dlandry8/alarmClock/notes 2020 1 1.jpg

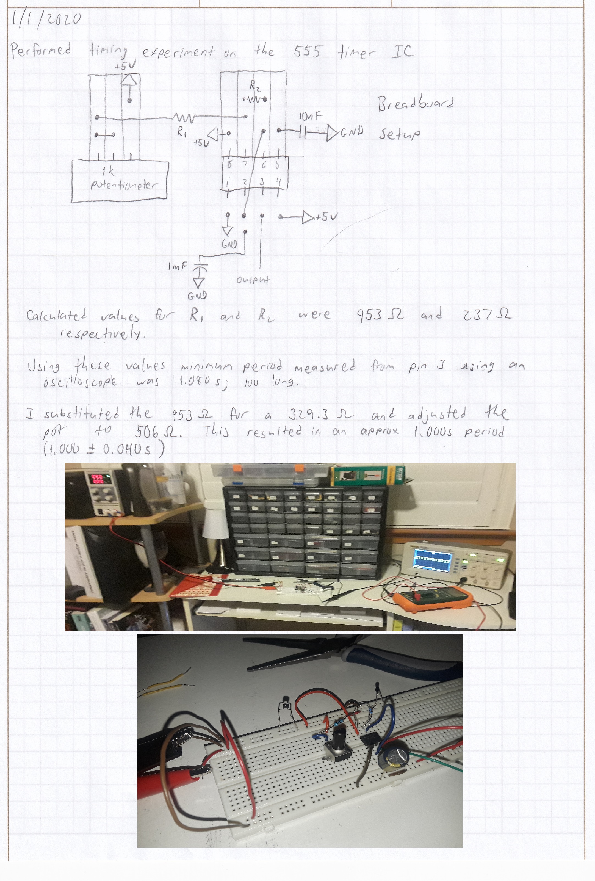
notes 2020 1 1.jpg
