dlandry8/alarmClock/box for clock.jpg

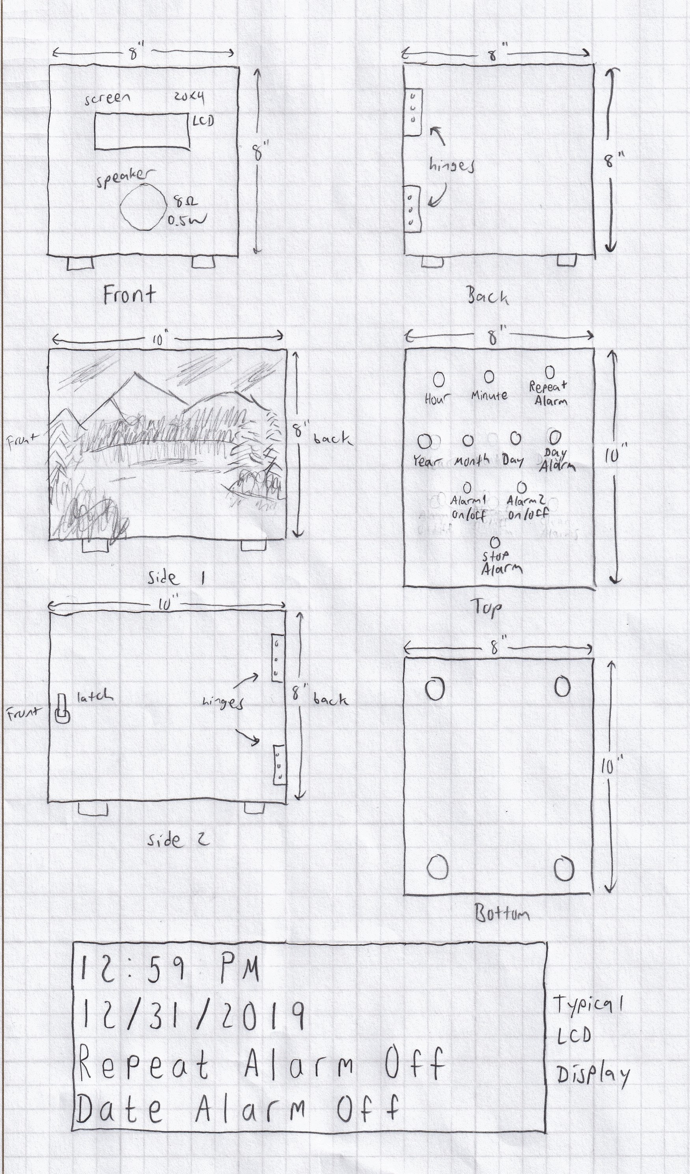
box for clock.jpg
