dlandry8/alarmClock/clock 0.8 Beeper.jpg

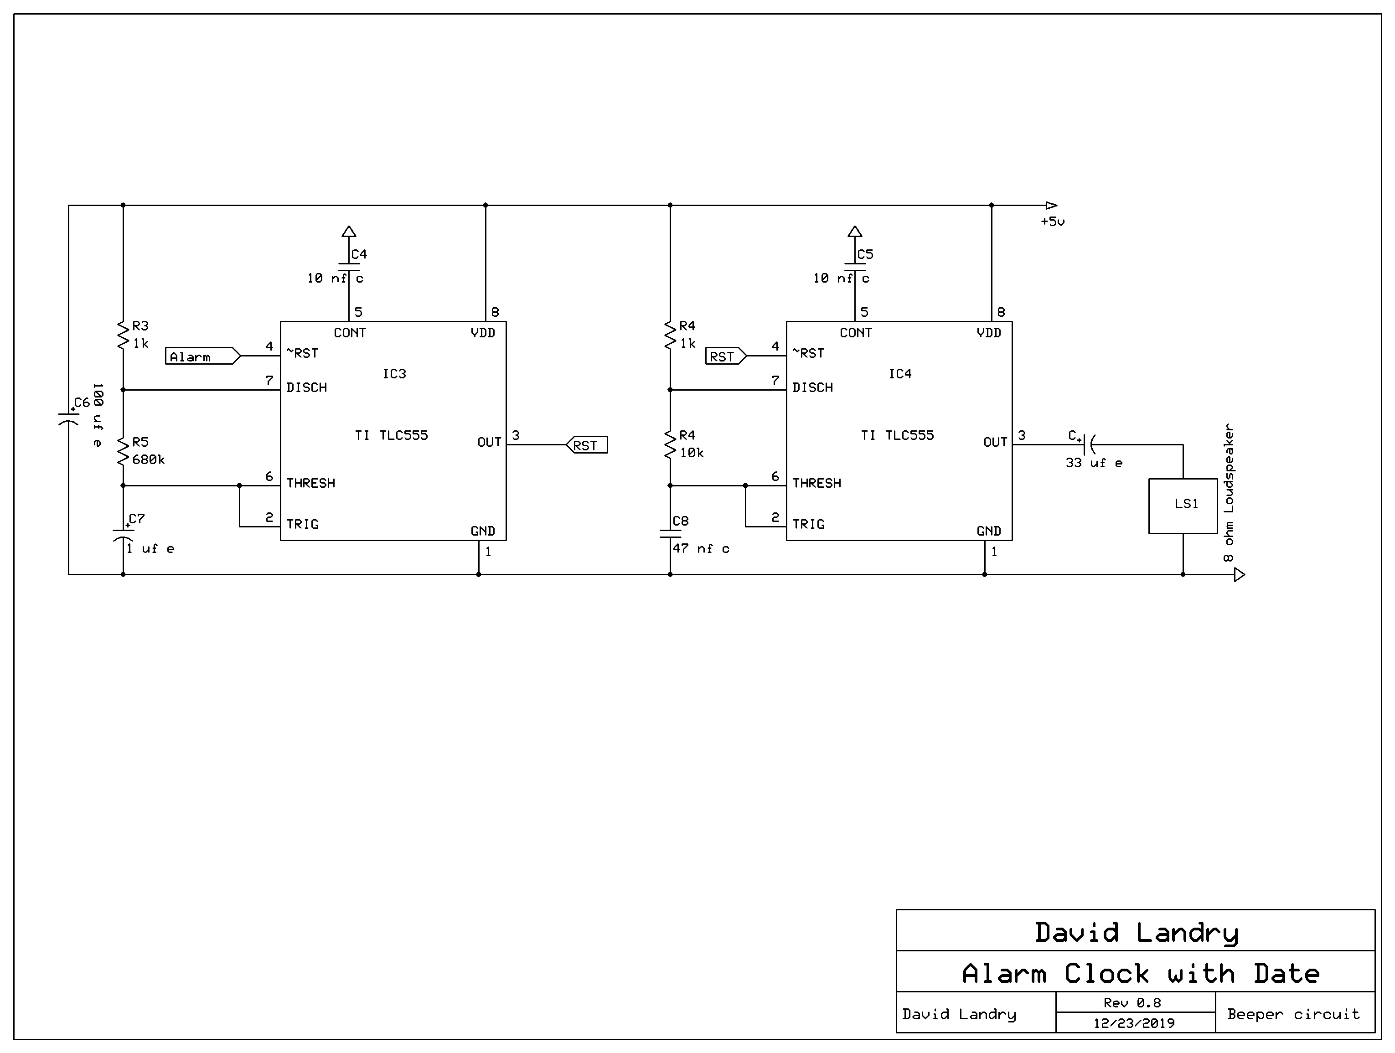
clock 0.8 Beeper.jpg
