dlandry8/alarmClock/clock 0.8 Buttons_Adapters.jpg

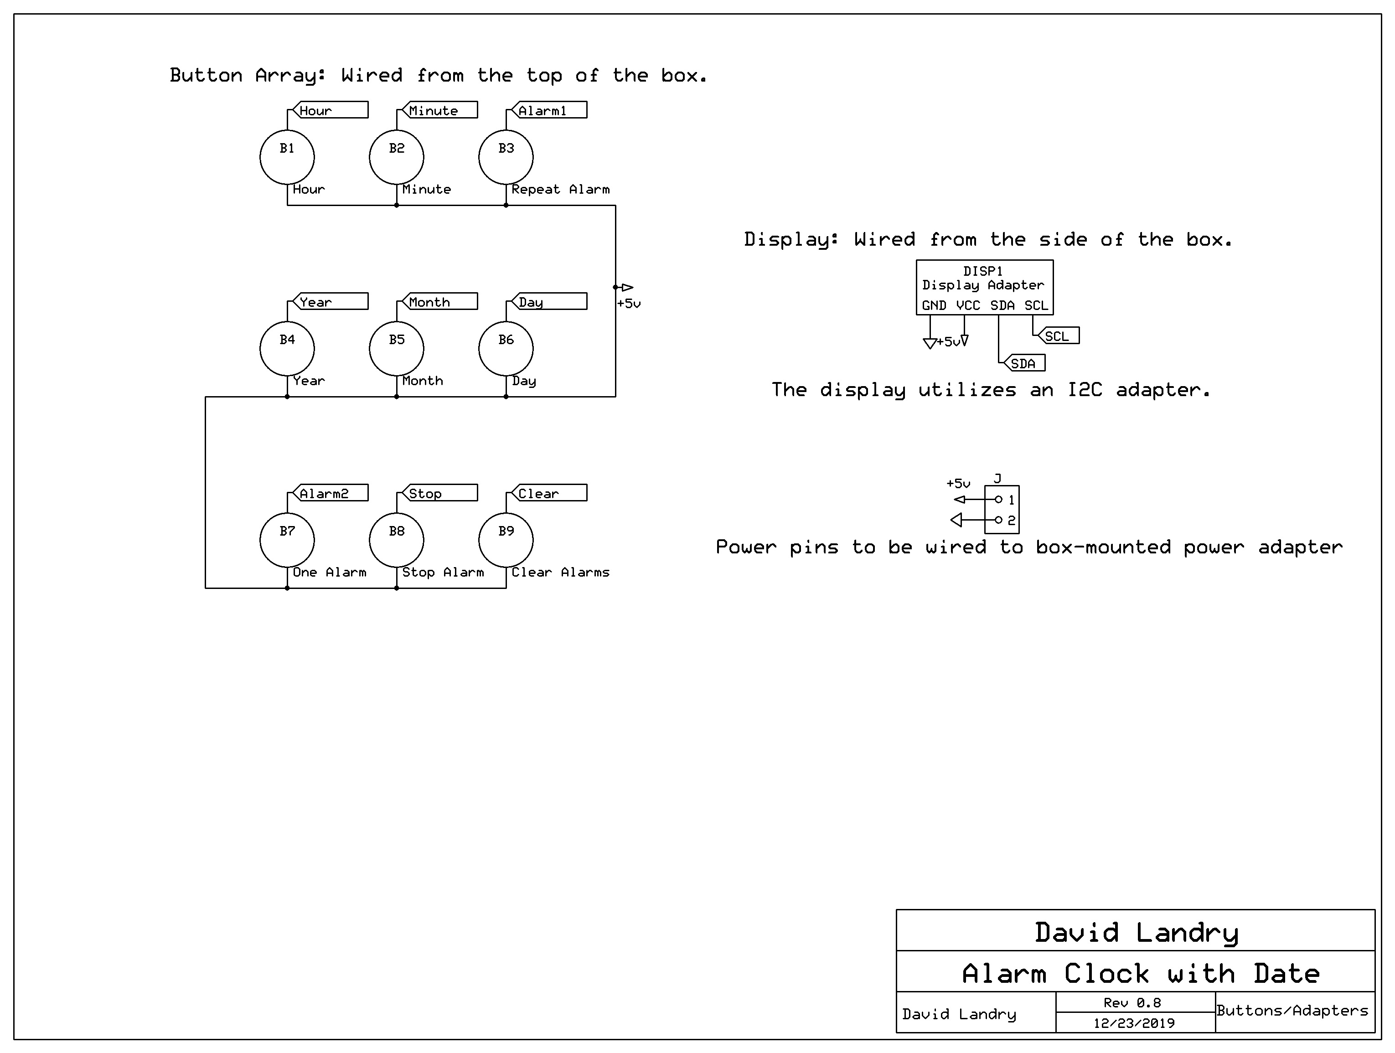
clock 0.8 Buttons_Adapters.jpg
