dlandry8/alarmClock/clock 0.8 Controllers.jpg

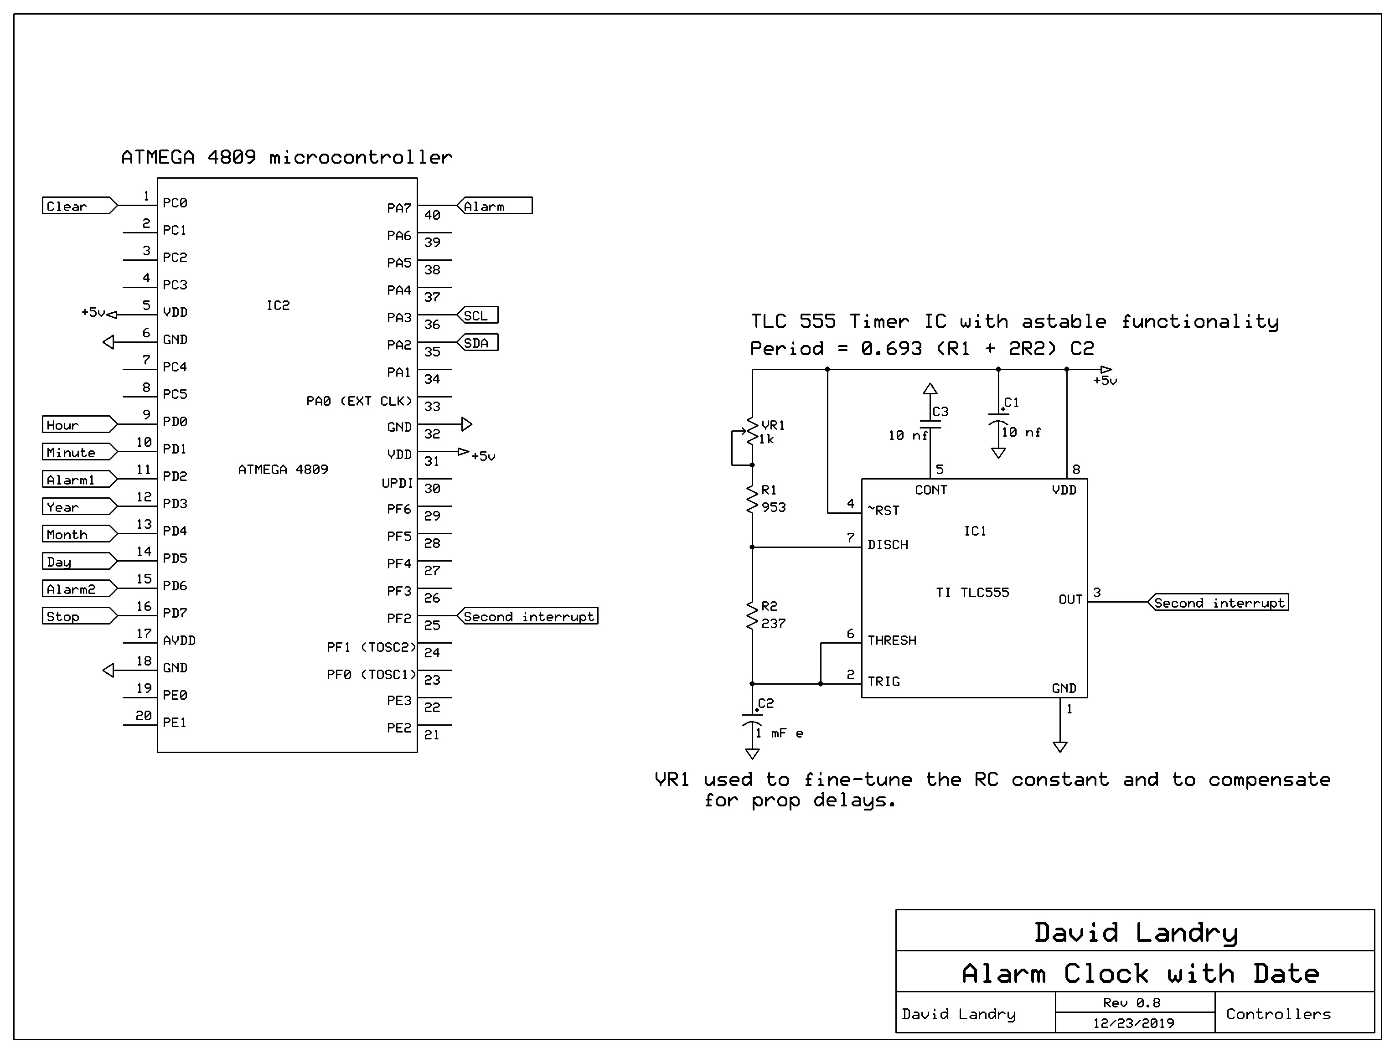
clock 0.8 Controllers.jpg
