dlandry8/alarmClock/working parts and tool list.xlsx

Part | Qty | Status
Circuitry
TLC555 Timing IC | 3 | Ordered
ATMEGA 4809 uC | 1 | Ordered
953 ohm resistor | 1 | Ordered
237 ohm resistor | 1 | Ordered
1k ohm resistor | 2 | Present
10k ohm resistor | 1 | Present
680k ohm resistor | 1 | Ordered
1k potentiometer | 1 | Ordered
1 mF capacitor | 1 | Ordered
10 nF capacitor | 5 | Ordered
100 uF capacitor | 1 | Ordered
47 nF capacitor | 1 | Ordered
33 uF capacitor | 1 | Ordered
Interface
20x4 LED screen | 1 | Present
Push buttons | 10 | Need
8 ohm loudspeaker | 1 | Need
Casing
Wood panels | 5 | Need
Wood base | 1 | Need
Round rubber feet | 4 | Need
Hinges | 2 | Need
Latch | 1 | Need
Rubber feet | 4 | Need
Material
Wood glue |  | Need
Acrylic paint |  | Need
Wood primer |  | Need
Solder |  | Need
Tools
Paintbrushes |  | Need
Clamp |  | Need
Soldering Iron |  | Need
Saw |  | Need
Atmel ICE programmer |  | Need
