dlandry8/alarmClock/(commit log)

2019-12-31 sketch of wooden box enclosure for the clock
2019-12-31 schematics and theory of operation
2019-12-31 parts and tool list
    [working parts and tool list.xlsx]
2019-12-31 update parts and tool list
    [working parts and tool list.xlsx]
2020-01-02 upload notes from experiment on timer circuit
